M3rcuryLake/k9Mesh/k9ui/README.md

# k9ui

Open in Bolt (https://bolt.new/~/sb1-avyjfezb)
