M3rcuryLake/k9Mesh/Circuit-Diagram.png

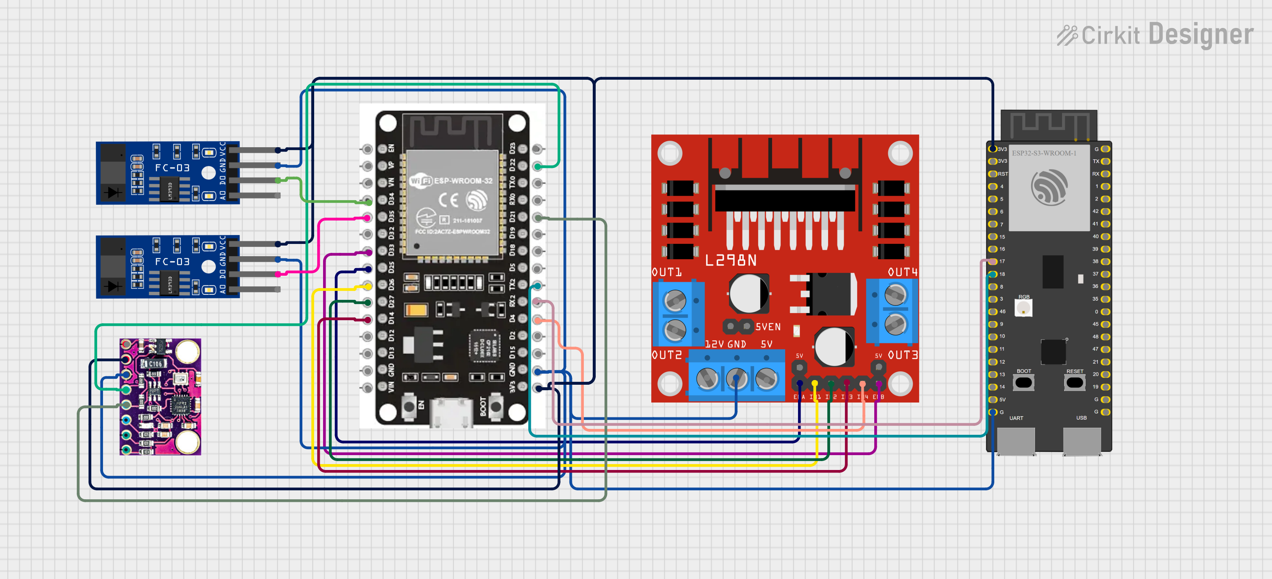
Circuit-Diagram.png
