M3rcuryLake/k9Mesh/(commit log)

2026-08-06 Implemented TelemetryHost and SystemHealthManager for monitoring, validating, and reporting telemetry flow in Electron
2026-08-08 Added auto-config, setup.py junk clear, windows support and caibration fail
    [config.py, main.py]
2026-09-09 v2 vodka-cran (in-dev): overhaul Wi-Fi pipeline and harden telemetry UI
    - Remove legacy src components, providers, and hooks
    - Remove Electron telemetry adapters and validation rules
    - Remove Wi-Fi test data and baseline files
    - Add host-side Wi-Fi sensor processing for respiration, spectrogram, and respiration flow
    - Update Wi-Fi/host main.py and collector with the new data pipeline
    - Prevent UI crashes caused by null telemetry
    - Fix HeaderBar telemetry access in App.tsx
    - Add defensive checks for toFixed() in MotionGraph, BreathingGraph, and AiGraph
    - Add defensive checks to mockGenerator.ts update()
    - Add telemetry validation in TelemetryProvider.tsx
    - Fix RoverMap Leaflet cleanup to prev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
    [main.py]
2026-09-10 feat: add rover teleoperation stack, DATASHEET update and runner.py server handling.
    - Add ESP32 transmitter (joystick) and receiver (motor/sensor) Arduino sketches
    using ESP-NOW at 20Hz with arcade mixing and deadman switch
    - Rewrite DATASHEET.md with complete pinouts, power distribution, and operating conditions
    - Add runner.py process manager for bridge/vite with signal handling
    - Bridge: fix path resolution, add model path + port args, detect first packet
    - UI: add "starting" status waiting for FIRST_PACKET_RECEIVED before "running"
    - Spectrogram: simplify colormap to HSV-based gradient
    - Remove legacy wifi/ws.py test server
    - Add circuit diagram
    [main.py, receiver.ino, transmitter.ino]
2026-09-15 docs: rewrite README for the v2 ESP32/CSI architecture
2026-09-20 v2.1 Bombay Sapphire (in-dev): implement complex-valued Wi-Fi CSI respiration pipeline
    - Replace legacy amplitude-only path with complex-valued CSCR/GASS
    pipeline on ESP32-S3
    - Add breath/ package: timestamp normalization, motion gating, static
    removal, CSCR candidate bank, complex projection, filtering (Hampel/
    Savitzky-Golay/Butterworth), FFT + BSSF dual estimators, quality gating,
    temporal fusion, and structured JSON output
    - Add GASS genetic algorithm optimizer with warm-start support
    - Replace legacy detect_breath() in main.py with RespirationPipeline
    - Update receiver.py with lazy complex CSI parsing (I/Q order configurable)
    - Extend frontend types (BreathData) and add breathi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
